AEttinger/arduino-heating-stage/README.md

# arduino-heating-stage
A do-it-yourself heating stage with arduino for Leica microscopes.
