AEttinger/arduino-heating-stage/docs/_posts/1-design.md

---
category: docs
head_image: '/assets/images/cad-stage-inset.png'
---
