AEttinger/arduino-heating-stage/docs/index.md

---
title: "Arduino heating stage"
tag: arduino hardware
layout: page
---

<div class="container marketing">
  <div class="row">
  {% assign item_number = site.project_description | size %}
  {% assign container_size = 12 | divided_by: item_number %}
    {% for item in site.project_description %}
      {% assign section_title = item.title | split: " " %}
      <div class="col-lg-{{ container_size }}">
        {{ item.head_image | remove:
        <h2> {{ section_title[1] | capitalize }} </h2>
        
        <p><a class="btn btn-secondary" href="#{{ item.title | replace: " ", "-" | downcase }}" role="button">View details &raquo;</a></p>
      </div>
    {% endfor %}
  </div>
</div>

<hr class="featurette-divider">

<div class="container">
  <div class="row">
    <div class="col-sm-12 blog-main">
      {% for item in site.project_description %}
        {% assign section_title = item.title | split: " " %}
        <div class="blog-post">
          <h2 class="blog-post-title" id="{{ item.title | replace: " ", "-" | downcase }}">{{ section_title[1] }}</h2>
          {{ item.content }}
        </div>
        
      {% endfor %}
    </div>
  </div>
</div>
