AEttinger/arduino-heating-stage/docs/_project_description/2-arduino.md

---
layout: desc
head_image: '/assets/images/arduino-and-shield-part.jpg'
---
