AEttinger/arduino-heating-stage/docs/assets/images/arduino-and-shield-part.jpg

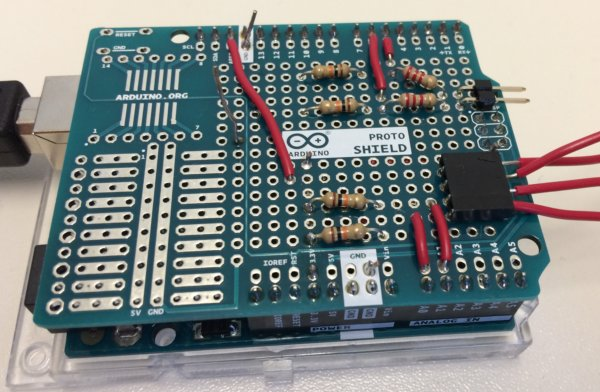
docs/assets/images/arduino-and-shield-part.jpg
