AEttinger/arduino-heating-stage/docs/assets/images/box-cuts.jpg

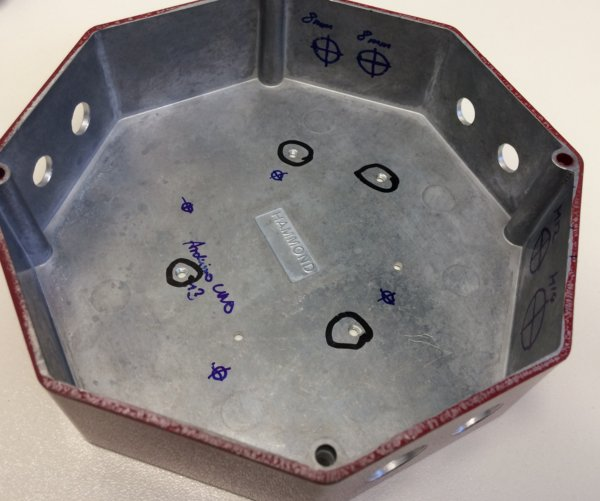
docs/assets/images/box-cuts.jpg
