AEttinger/arduino-heating-stage/docs/assets/images/carousel/first_image.png

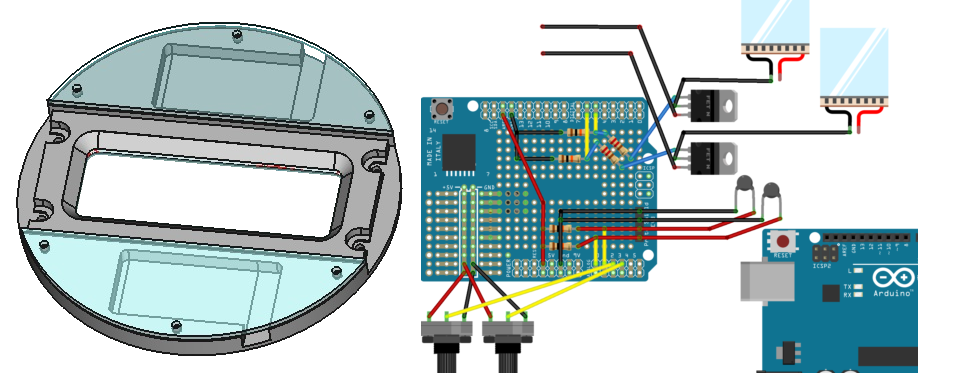
docs/assets/images/carousel/first_image.png
