AEttinger/arduino-heating-stage/docs/assets/images/carousel/second_image.jpg

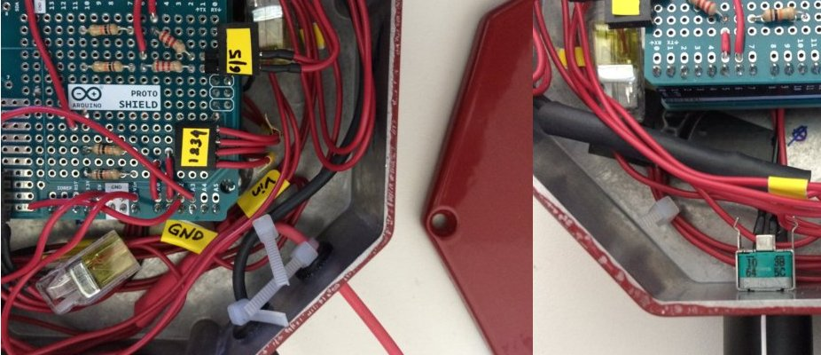
docs/assets/images/carousel/second_image.jpg
