AEttinger/arduino-heating-stage/docs/assets/images/carousel/third_image.jpg

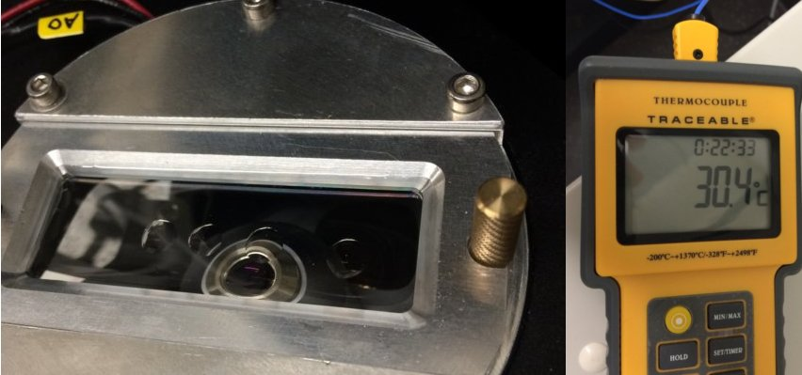
docs/assets/images/carousel/third_image.jpg
