AEttinger/arduino-heating-stage/docs/assets/images/code.png

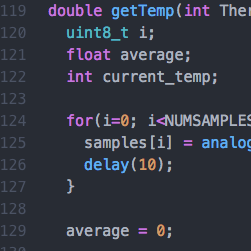
docs/assets/images/code.png
