AEttinger/arduino-heating-stage/docs/assets/images/mosfet-cooling.jpg

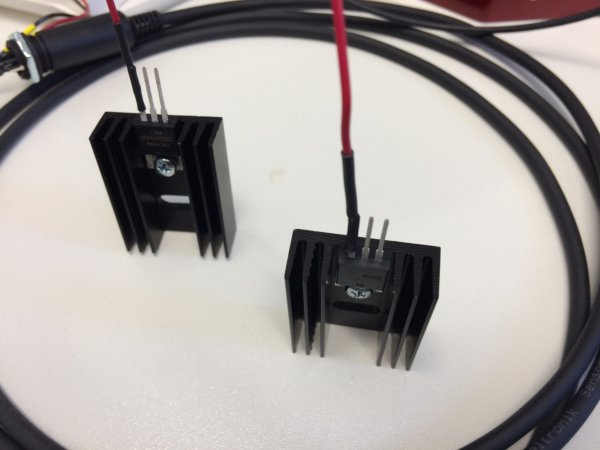
docs/assets/images/mosfet-cooling.jpg
