AEttinger/arduino-heating-stage/docs/assets/images/potentiometers-connectors.jpg

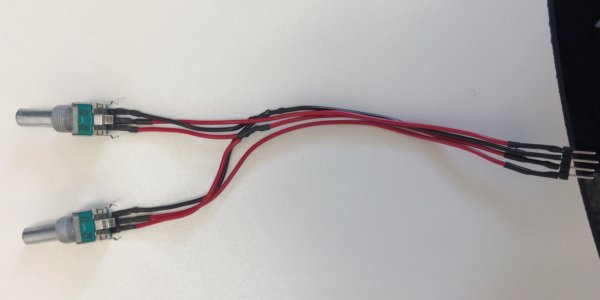
docs/assets/images/potentiometers-connectors.jpg
