AEttinger/arduino-heating-stage/docs/assets/images/potentiometers-detail.jpg

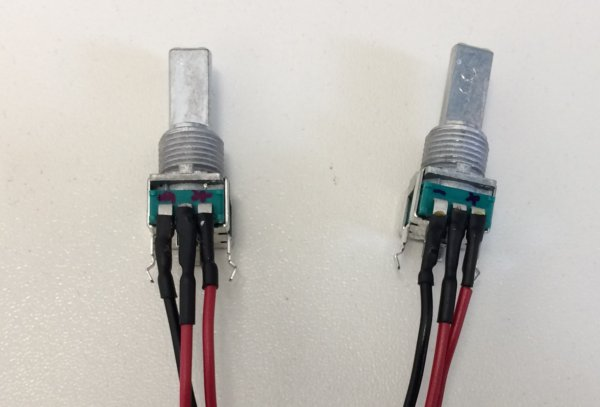
docs/assets/images/potentiometers-detail.jpg
