AEttinger/arduino-heating-stage/docs/assets/images/stage-inset-glue-thermistor-detail.jpg

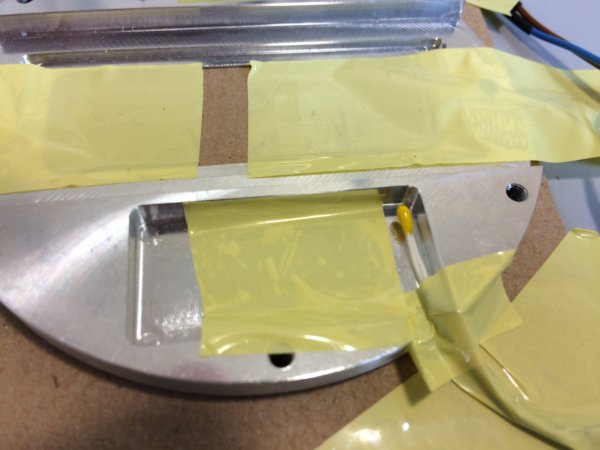
docs/assets/images/stage-inset-glue-thermistor-detail.jpg
