AEttinger/arduino-heating-stage/docs/assets/images/stage-inset-in-action.jpg

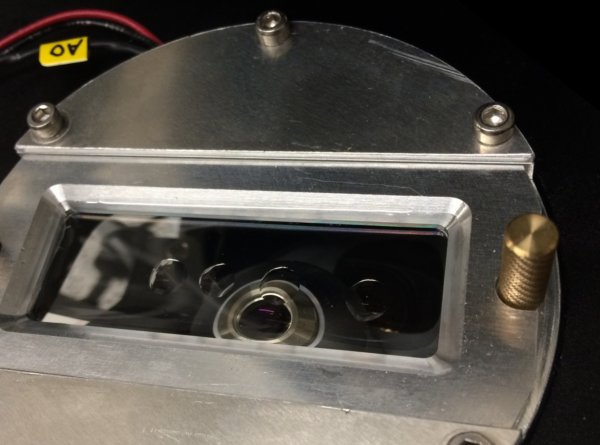
docs/assets/images/stage-inset-in-action.jpg
