AEttinger/arduino-heating-stage/docs/assets/images/stage-inset-thermistor-glued.jpg

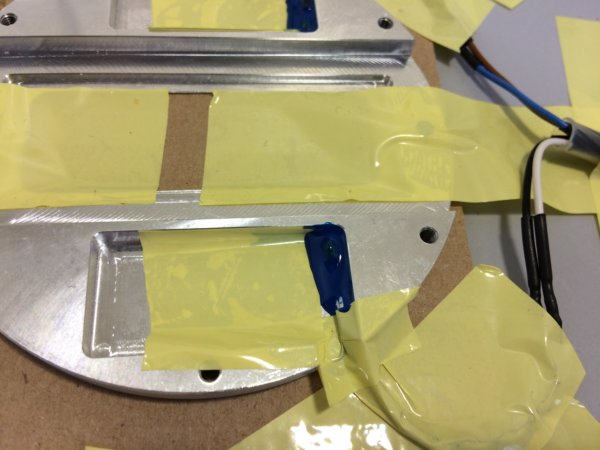
docs/assets/images/stage-inset-thermistor-glued.jpg
