AEttinger/arduino-heating-stage/docs/assets/images/stage-lid.jpg

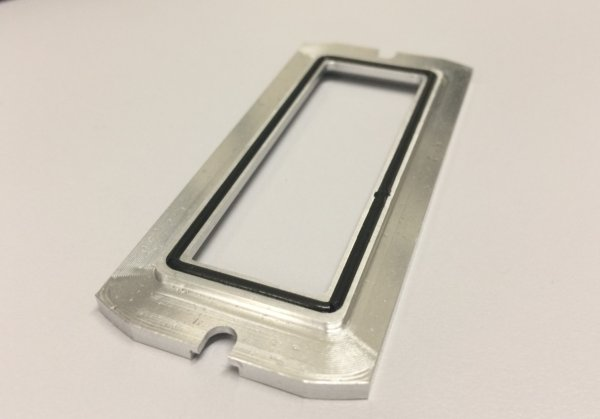
docs/assets/images/stage-lid.jpg
