AEttinger/arduino-heating-stage/docs/assets/images/thermistor-connector.jpg

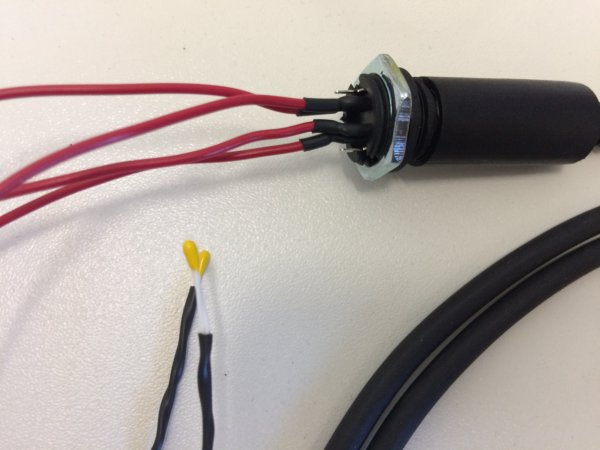
docs/assets/images/thermistor-connector.jpg
