AEttinger/arduino-heating-stage/microinjector_heater_15x30peltiers.fcstd

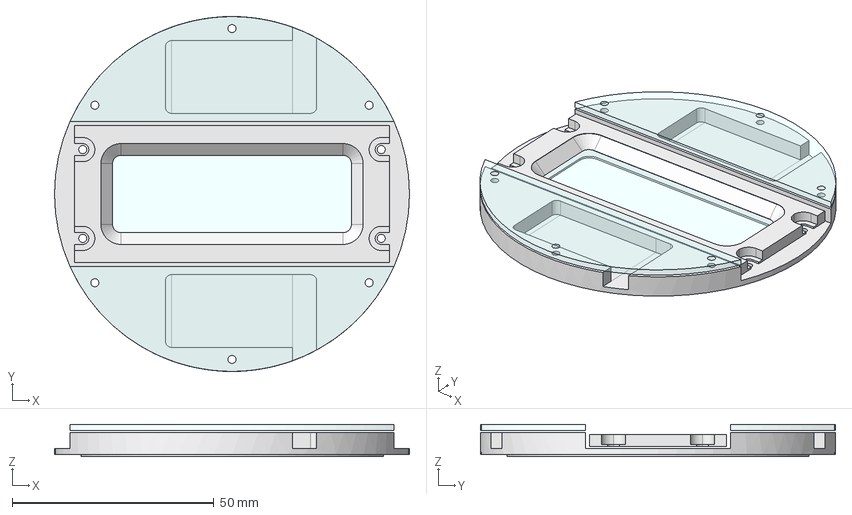
[picture p19: CAD file, 2018-01-05]
microinjector_heater_15x30peltiers.fcstd
88.0 x 88.0 x 8.00 mm
Coverglass
Lid
Baseplate
Cover
