AEttinger/arduino-heating-stage/docs/_project_description/3-assembly.md

---
layout: desc
head_image: '/assets/images/box-assembly-detail.jpg'
---
