AEttinger/arduino-heating-stage/docs/_posts/3-assembly.md

---
category: docs
head_image: '/assets/images/box-assembly-detail.jpg'
---
