AEttinger/arduino-heating-stage/docs/_posts/2-wiring.md

---
category: docs
head_image: '/assets/images/arduino-and-shield-part.jpg'
---
