AEttinger/arduino-heating-stage/docs/assets/images/box-assembly-arduino-and-shield.jpg

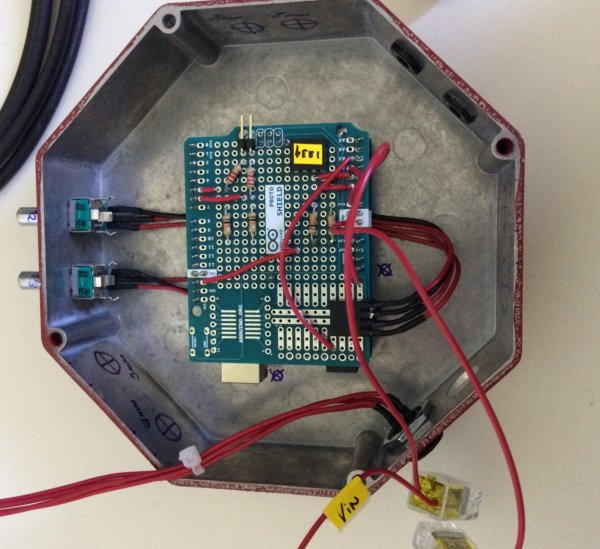
docs/assets/images/box-assembly-arduino-and-shield.jpg
