AEttinger/arduino-heating-stage/docs/assets/images/box-assembly-arduino.jpg

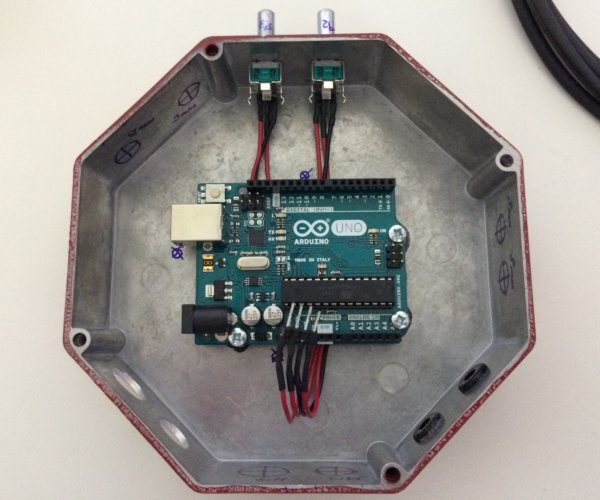
docs/assets/images/box-assembly-arduino.jpg
