AEttinger/arduino-heating-stage/docs/assets/images/box-assembly-completed.jpg

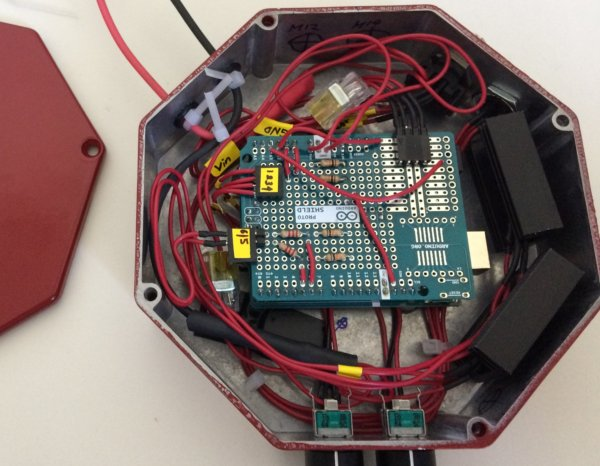
docs/assets/images/box-assembly-completed.jpg
