AEttinger/arduino-heating-stage/docs/assets/images/box-assembly-detail-2.jpg

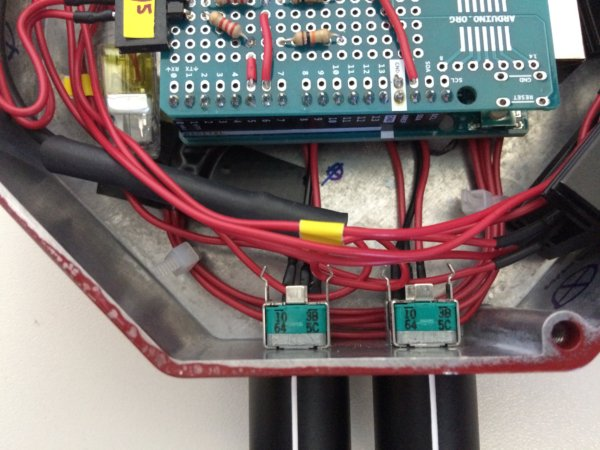
docs/assets/images/box-assembly-detail-2.jpg
