AEttinger/arduino-heating-stage/docs/assets/images/box-assembly-detail-mosfets.jpg

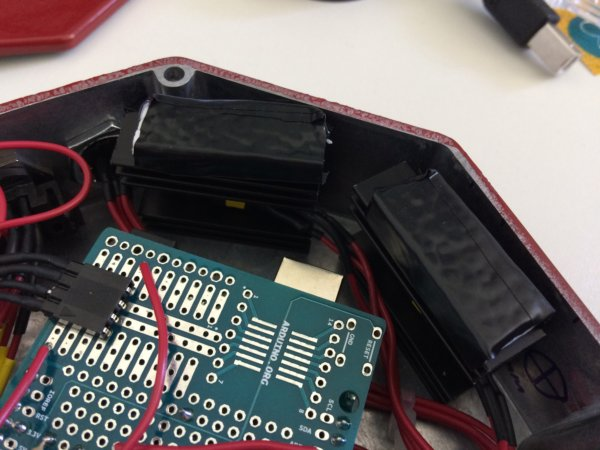
docs/assets/images/box-assembly-detail-mosfets.jpg
