AEttinger/arduino-heating-stage/docs/assets/images/box-assembly-detail.jpg

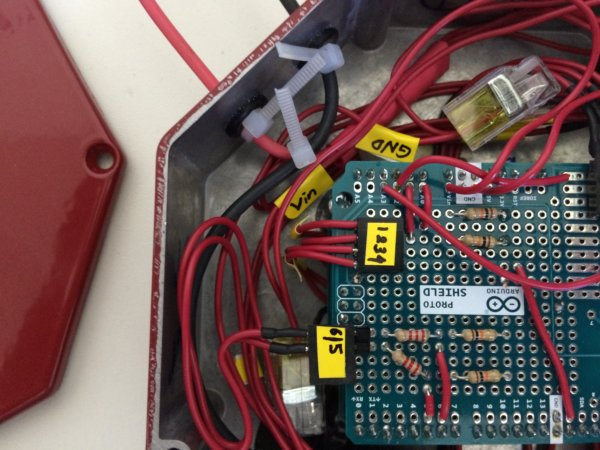
docs/assets/images/box-assembly-detail.jpg
