AEttinger/arduino-heating-stage/docs/assets/images/stage-inset-assembled-on-stage.jpg

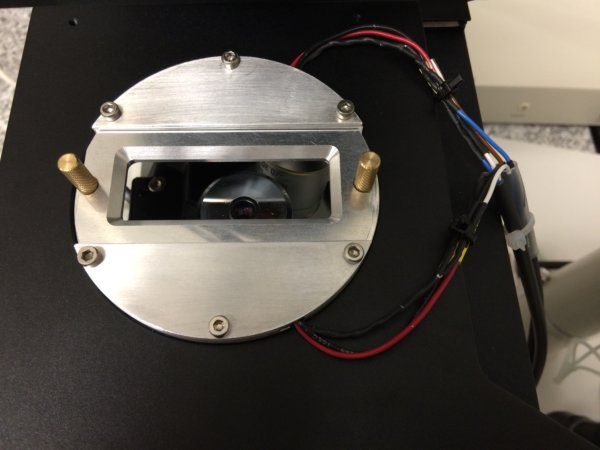
docs/assets/images/stage-inset-assembled-on-stage.jpg
