AEttinger/arduino-heating-stage/docs/assets/images/temperature-test.jpg

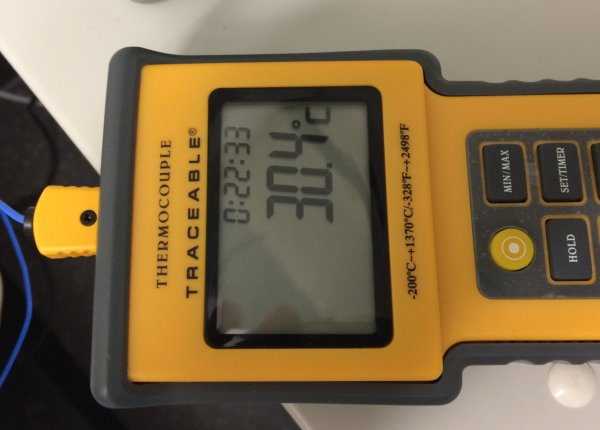
docs/assets/images/temperature-test.jpg
