AEttinger/arduino-heating-stage/(commit log)

2018-01-05 upload images
    [microinjector_heater_15x30peltiers.fcstd]
2018-01-20 switch to collection
2018-01-20 add cad description
